tdorssers/weather-station/README.md

# weather-station

## Base

 A BME280 barometric sensor is used to implement a simple Zambretti weather forecasting algorithm by calculating the Pa/h trend. Up to 16 wireless DS18B20, AM2320, AHT20 or SHT30 sensors transmit NRZ encoded packets with CRC data using a 433MHz ASK/OOK module connected to the hardware UART at 1200 baud. Up to 6 remote sensors are shown on the LCD. Minimum and maximum temperatures and humidity values are stored in 4 six hour periods. A software UART implementation using Timer1 is interfacing with the GPS module at 9600 baud. Libc timekeeping uses the GPS position to determine day and night display mode, which can be overridden from the menu. Time zone and daylight saving time can be set from the menu which is shown by touching the main screen. Different temperature and pressure units can be selected. The LCD back light level is auto adjusted using a 5528 LDR and can be set manually. Screen orientation can be adjusted and the touch screen requires calibration which is done by touching the screen edges. The remote sensors can be named with 3 characters from the menu. Calibration and names are stored in EEPROM.

It uses a speed optimized ILI9341 driver for AVR which implements graphics drawing primitives and uses openGLCD library fonts.

### Hardware

* ATmega328P @ 12 MHz
* RFM210LCF 433MHz ASK/OOK receiver module
* BME280 digital humidity, pressure and temperature sensor
* ILI9341 driver for 240x320 TFT LCD module
* XPT2046 touch screen controller
* NEO-6M GPS module
* GL5528 LDR

### Schematic

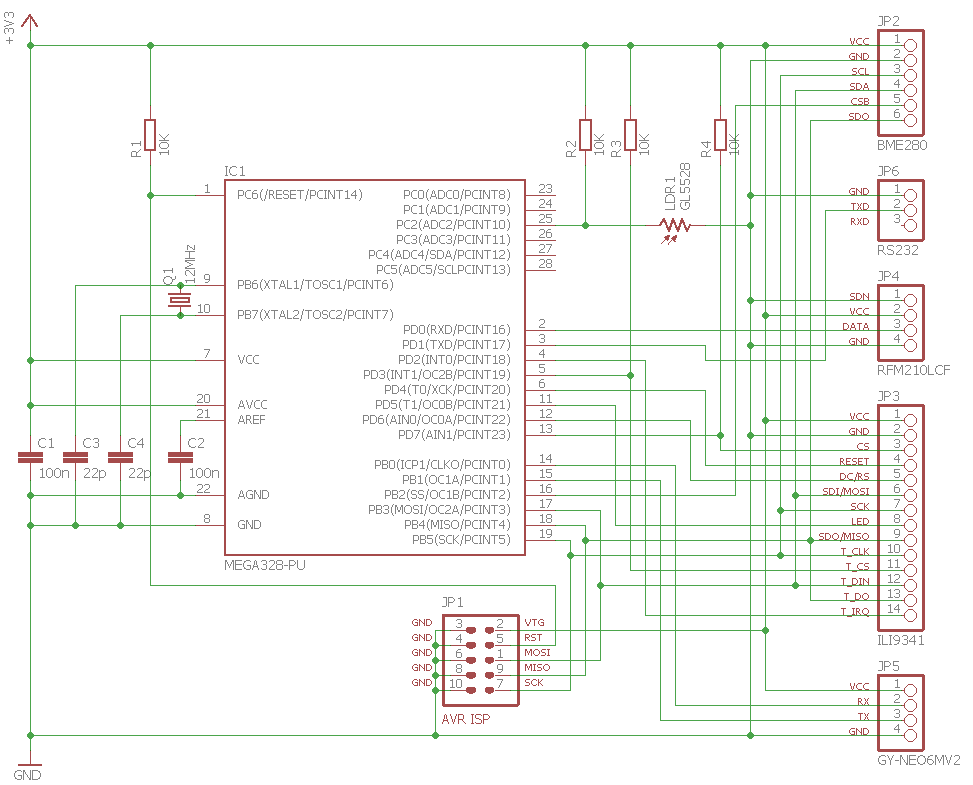
[picture p1: schematic/base.png]


### Prototype

Day time display mode:

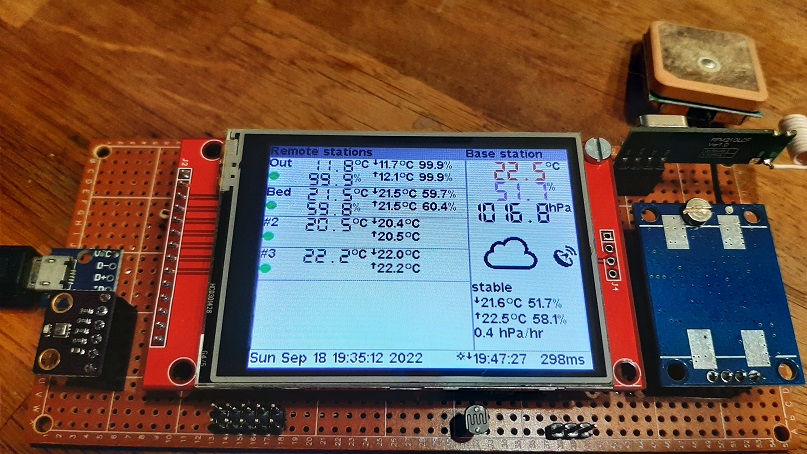
[picture p2: media/base_station_day.jpg]


Night time display mode:

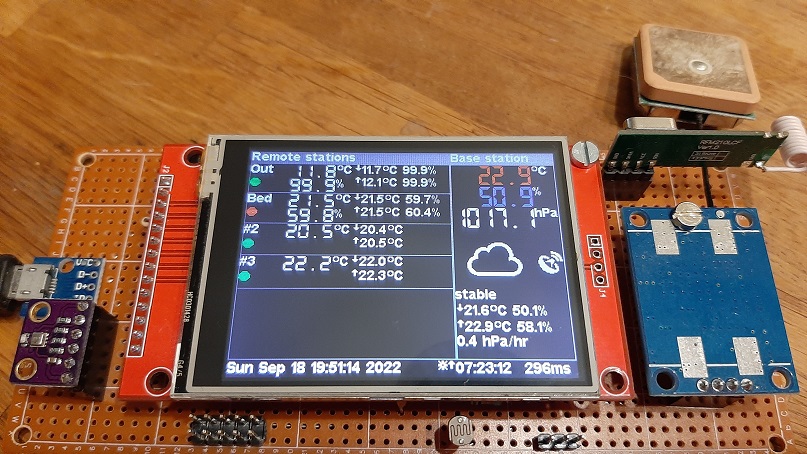
[picture p3: media/base_station_night.jpg]


Main menu with touch buttons:

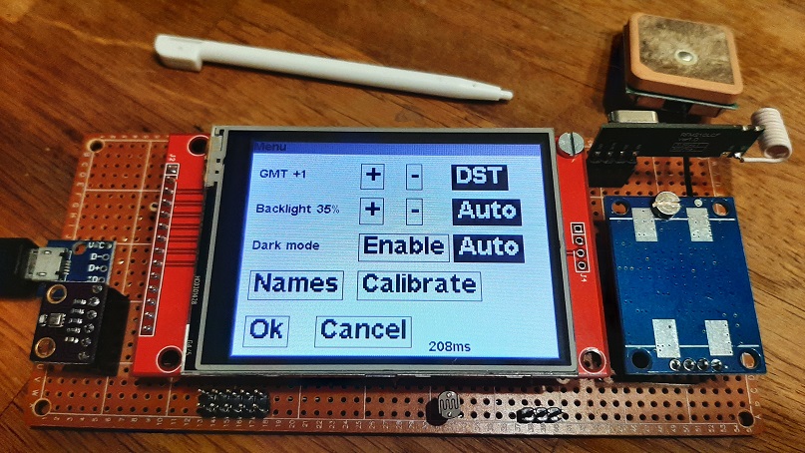
[picture p4: media/base_station_menu.jpg]


Touch screen keyboard to name remote sensors:

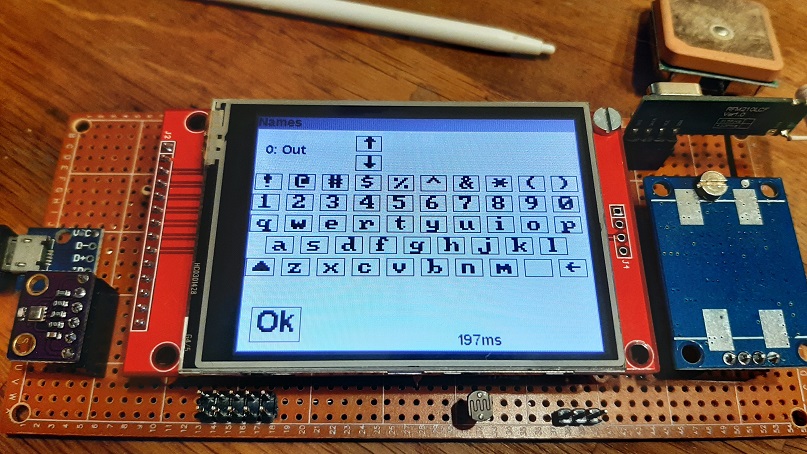
[picture p5: media/base_station_keys.jpg]


## Remote ATtiny25/45/85

Remote temperature sensor module with drivers for DS18B20, AM2320, AHT20 and SHT30 sensor. The DIP switches are used to set the unit address. Every 8 seconds a NRZ encoded packet with CRC data is transmitted using a 433MHz ASK/OOK module connected to the USI UART at 1200 baud. Compiling for an ATtiny25 disables the SHT30 driver and requires `-Os`.

### Hardware

* ATtiny25/45/85 @ 1 MHz
* RFM85 433MHz ASK/OOK transmitter module
* AHT20/AM2320/SHT30 digital temperature and humidity sensor
* DS18B20 digital temperature sensor
* 4 DIP switches

### Schematic

AHT20/AM2320/SHT30 wiring:

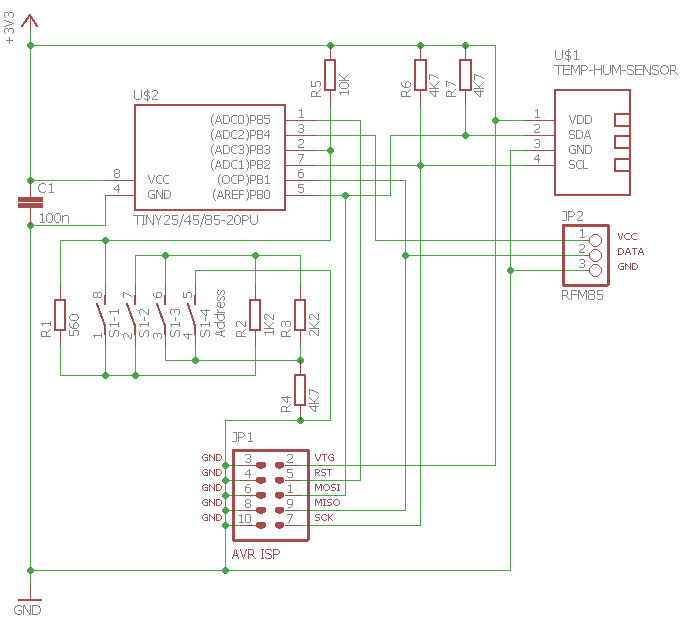
[picture p6: schematic/remote_25_45_85.png]


DS18B20 wiring:

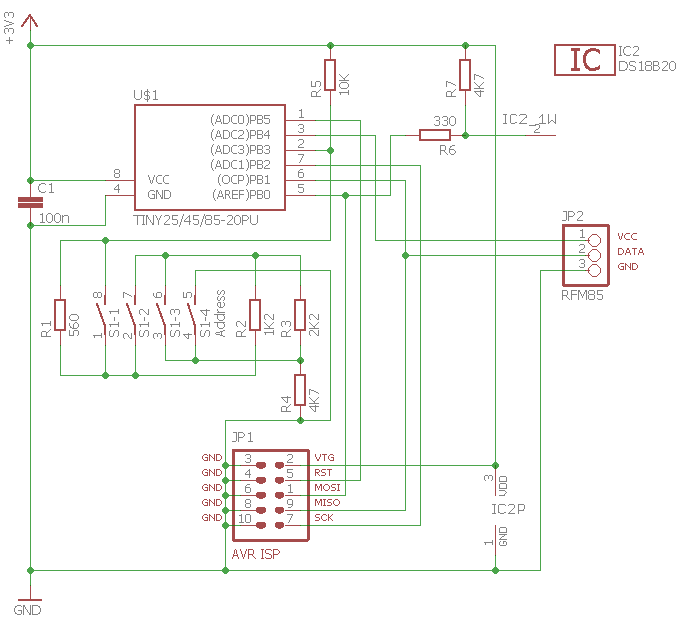
[picture p7: schematic/remote_25_45_85-1wire.png]


### Prototype

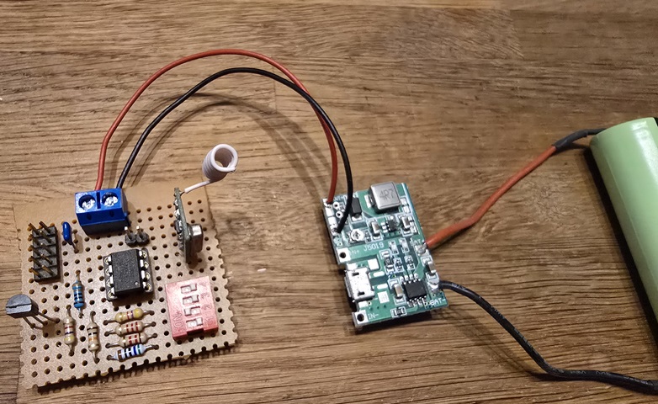
[picture p8: media/remote_25_45_85.jpg]


## Remote ATtiny2313/2313A/4313

Remote temperature sensor module with drivers for DS18B20, AM2320, AHT20 and SHT30 sensor. The DIP switches are used to set the unit address. Every 8 seconds a NRZ encoded packet with CRC data is transmitted using a 433MHz ASK/OOK module connected to the hardware USART at 1200 baud. Compiling for an ATtiny4313 enables the SHT30 driver.

### Hardware

* ATtiny2313/2313A/4313 @ 1 MHz
* RFM85 433MHz ASK/OOK transmitter module
* AHT20/AM2320 digital temperature and humidity sensor
* DS18B20 digital temperature sensor
* 4 DIP switches

### Schematic

AHT20/AM2320 wiring:

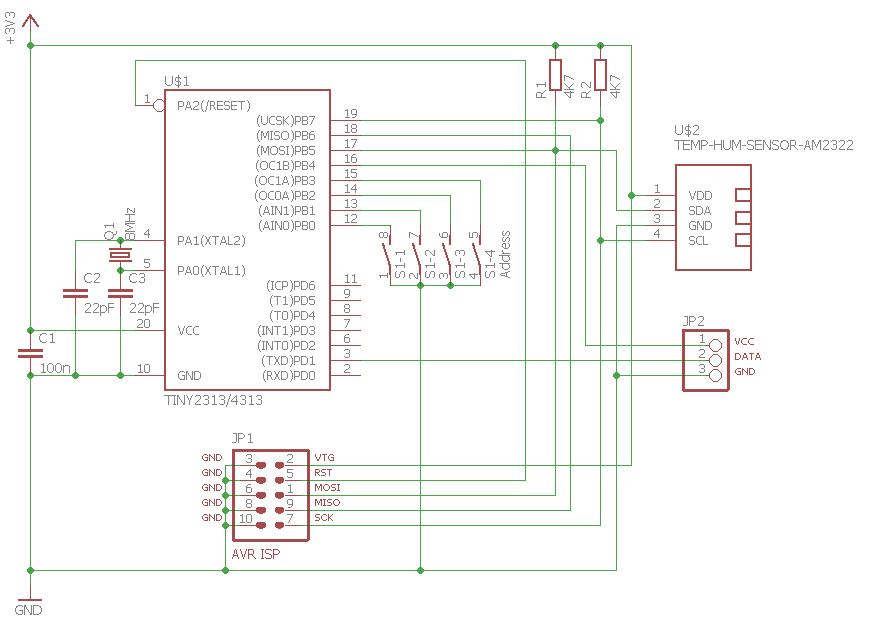
[picture p9: schematic/remote_2313_4313.png]


DS18B20 wiring:

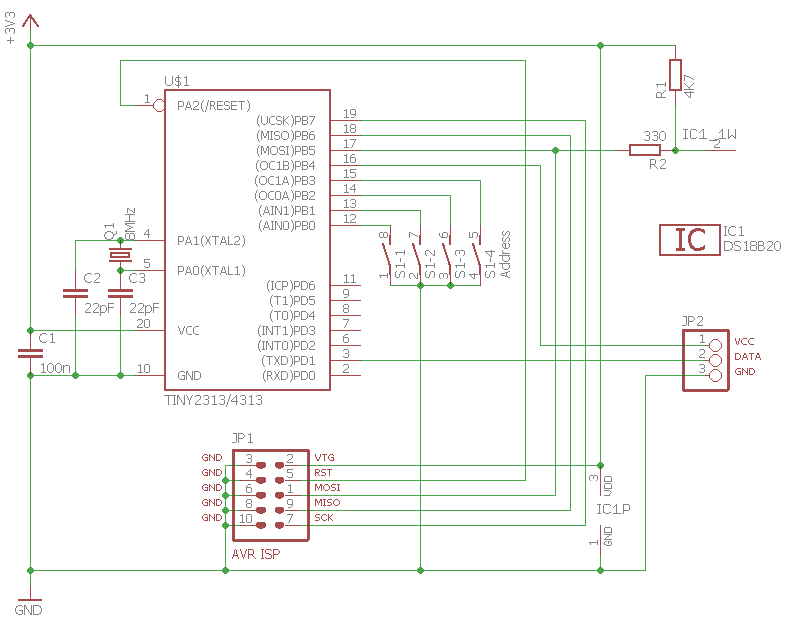
[picture p10: schematic/remote_2313_4313-1wire.png]

 
### Prototype

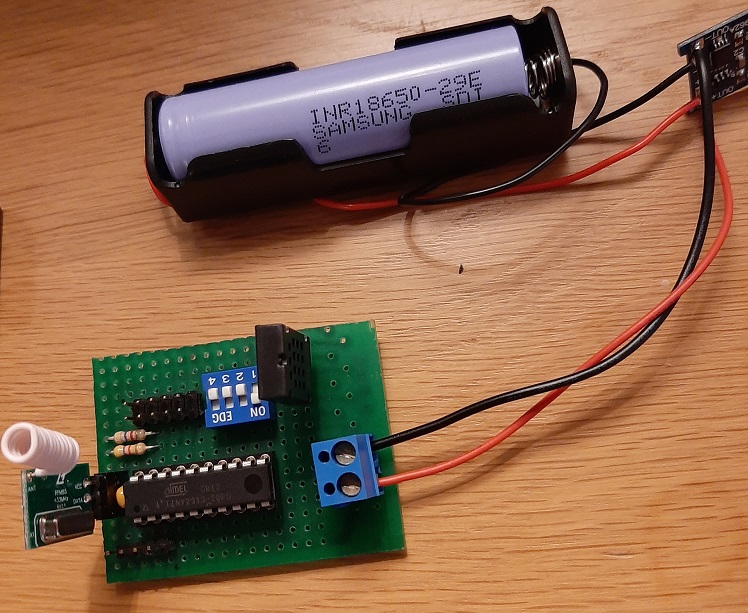
[picture p11: media/remote_2313_4313.jpg]


## Firmware
The firmware has been developed in Atmel Studio 7 using GCC C and can be uploaded to the AVR using the ISP connector and an ISP programmer such as [USBasp tool](http://www.fischl.de/usbasp/) using [avrdude](http://www.nongnu.org/avrdude/).

### Base

`avrdude -p m328p -c usbasp -U flash:w:base.hex:i -U lfuse:w:0x62:m -U hfuse:w:0xdf:m`

### Remote ATtiny2313/2313A/4313

`avrdude -p t2313 -c usbasp -U flash:w:remote_2313_4313.hex:i -U lfuse:w:0x7f:m -U hfuse:w:0xdf:m`

### Remote ATtiny25/45/85

`avrdude -p t85 -c usbasp -U flash:w:remote_25_45_85.hex:i -U lfuse:w:0x62:m -U hfuse:w:0xdf:m`
