tdorssers/weather-station/schematic/base.sch

## EAGLE design schematic/base.sch (2024-12-08)

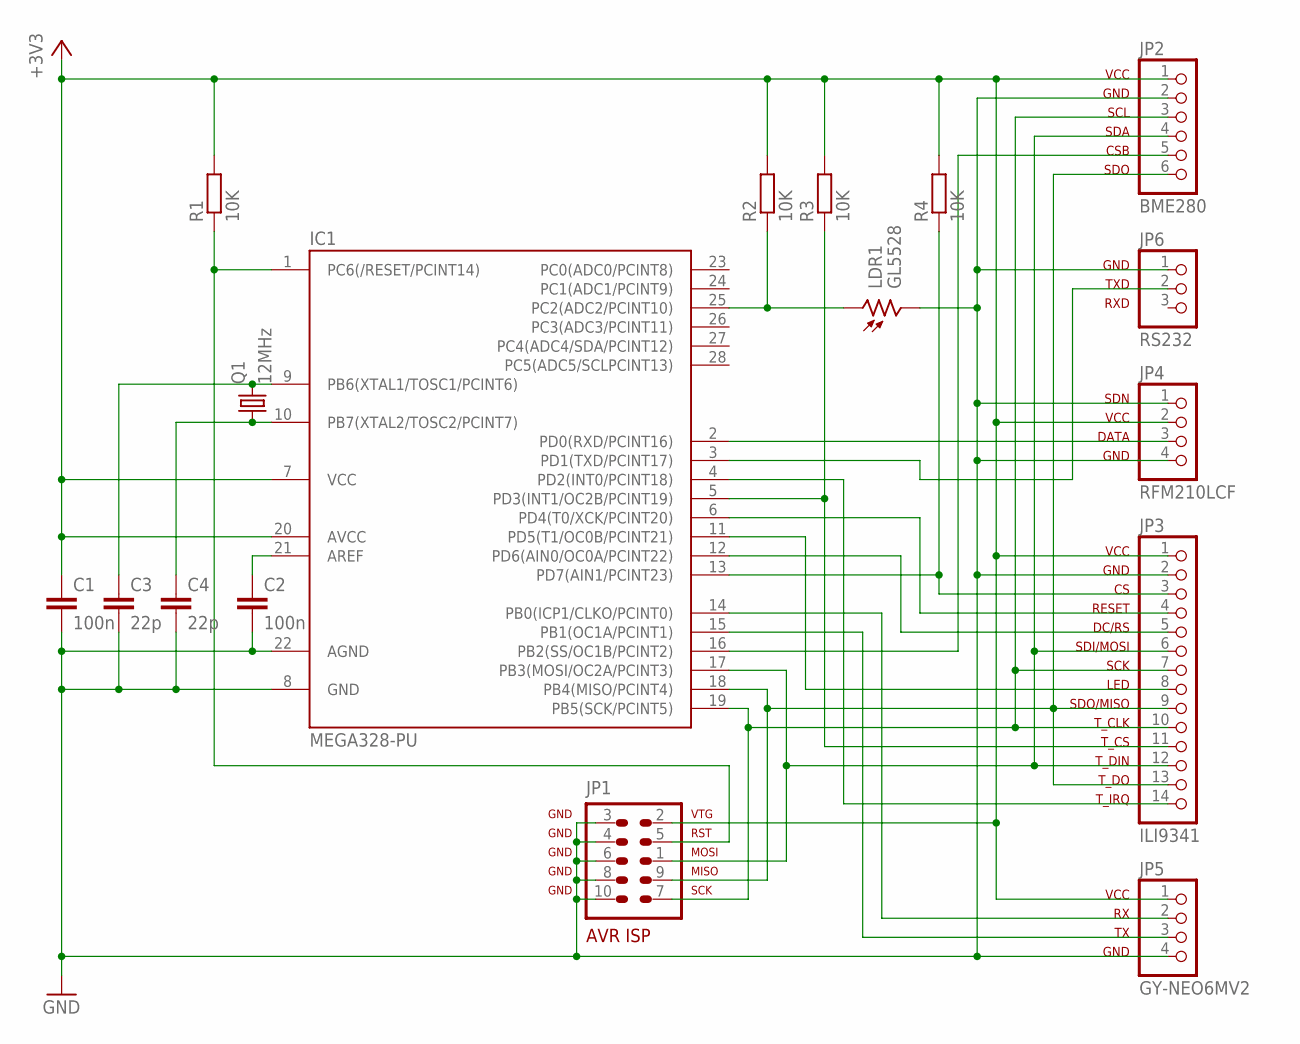
[picture p12: schematic base.sch]

Parts:
C1, C2: 100n; C025-025X050
C3, C4: 22p; C025-025X050
IC1: MEGA328-PU; DIL28-3
JP1: AVR-ISP-10
JP2: BME280; 1X06
JP3: ILI9341; 1X14
JP4: RFM210LCF; 1X04
JP5: GY-NEO6MV2; 1X04
JP6: RS232; 1X03
LDR1: GL5528; TO46-VT200
Q1: 12MHz; HC49U-V
R1, R2, R3, R4: 10K; 0204/7

Connections:
+3V3: C1.1, IC1.7 (VCC), IC1.20 (AVCC), JP1.2, JP2.1, JP3.1, JP4.2, JP5.1, R1.2, R2.2, R3.2, R4.2
GND: C1.2, C2.2, C3.2, C4.2, IC1.8 (GND), IC1.22 (AGND), JP1.3, JP1.4, JP1.6, JP1.8, JP1.10, JP2.2, JP3.2, JP4.1, JP4.4, JP5.4, JP6.1, LDR1.2
unnamed: IC1.16 (PB2(SS/OC1B/PCINT2)), JP2.5
unnamed: IC1.1 (PC6(/RESET/PCINT14)), JP1.5, R1.1
unnamed: IC1.18 (PB4(MISO/PCINT4)), JP1.9, JP2.6, JP3.9, JP3.13
unnamed: C2.1, IC1.21 (AREF)
unnamed: IC1.2 (PD0(RXD/PCINT16)), JP4.3
unnamed: IC1.12 (PD6(AIN0/OC0A/PCINT22)), JP3.5
unnamed: IC1.13 (PD7(AIN1/PCINT23)), JP3.3, R4.1
unnamed: IC1.17 (PB3(MOSI/OC2A/PCINT3)), JP1.1, JP2.4, JP3.6, JP3.12
unnamed: IC1.4 (PD2(INT0/PCINT18)), JP3.14
unnamed: IC1.6 (PD4(T0/XCK/PCINT20)), JP3.4
unnamed: IC1.11 (PD5(T1/OC0B/PCINT21)), JP3.8
unnamed: IC1.19 (PB5(SCK/PCINT5)), JP1.7, JP2.3, JP3.7, JP3.10
unnamed: IC1.25 (PC2(ADC2/PCINT10)), LDR1.1, R2.1
unnamed: IC1.14 (PB0(ICP1/CLKO/PCINT0)), JP5.2
unnamed: IC1.15 (PB1(OC1A/PCINT1)), JP5.3
unnamed: IC1.5 (PD3(INT1/OC2B/PCINT19)), JP3.11, R3.1
unnamed: IC1.3 (PD1(TXD/PCINT17)), JP6.2
unnamed: C4.1, IC1.10 (PB7(XTAL2/TOSC2/PCINT7)), Q1.1
unnamed: C3.1, IC1.9 (PB6(XTAL1/TOSC1/PCINT6)), Q1.2

Notes on the sheet:
VCC GND SCL SDA CSB SDO
VCC GND CS RESET DC/RS SDI/MOSI SCK LED SDO/MISO T_CLK T_CS T_DIN T_DO T_IRQ
SDN VCC DATA GND
VCC RX TX GND
GND TXD RXD
