tdorssers/weather-station/schematic/remote_25_45_85-1wire.sch

## EAGLE design schematic/remote_25_45_85-1wire.sch (2024-12-22)

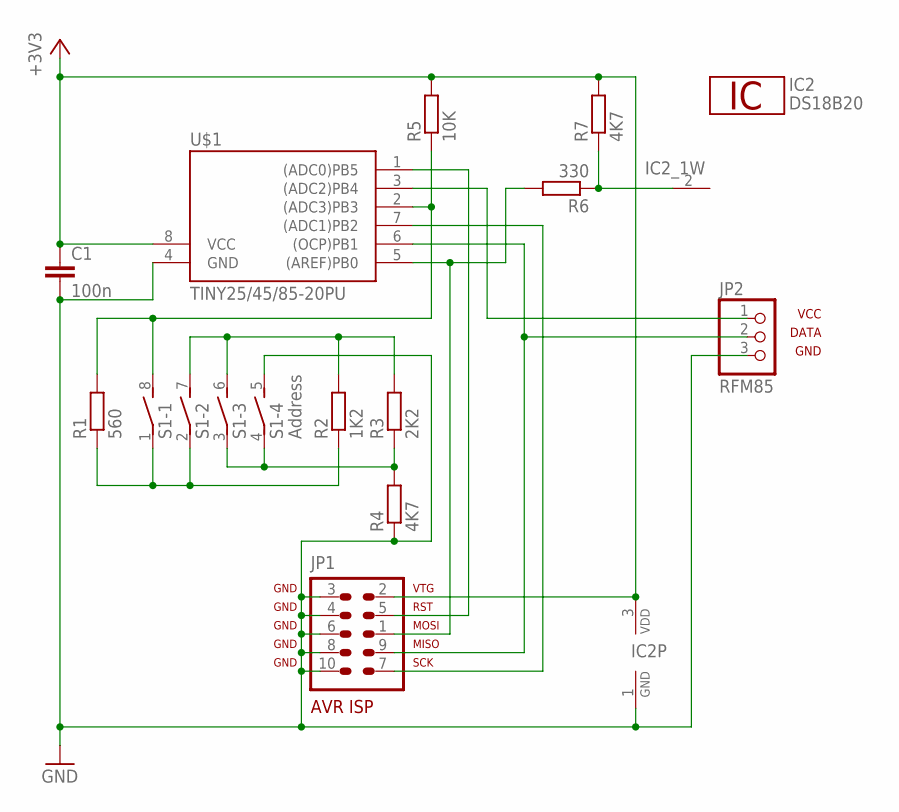
[picture p13: schematic remote_25_45_85-1wire.sch]

Parts:
C1: 100n; C025-025X050
IC2: DS18B20; TO92-
JP1: AVR-ISP-10
JP2: RFM85; 1X03
R1: 560; 0204/7
R2: 1K2; 0204/7
R3: 2K2; 0204/7
R4, R7: 4K7; 0204/7
R5: 10K; 0204/7
R6: 330; 0204/7
S1: Address; DIP04S
U$1: TINY25/45/85-20PU; SOIC8

Connections:
+3V3: C1.1, IC2.3 (VDD), JP1.2, R5.2, R7.2, U$1.8 (VCC)
GND: C1.2, IC2.1 (GND), JP1.3, JP1.4, JP1.6, JP1.8, JP1.10, JP2.3, R4.1, S1.5 (2), U$1.4 (GND)
unnamed: JP1.1, U$1.5 ((AREF)PB0)
unnamed: JP1.7, U$1.7 ((ADC1)PB2)
unnamed: JP1.9, JP2.2, U$1.6 ((OCP)PB1)
unnamed: R1.1, R2.1, S1.1, S1.2 (1)
unnamed: JP2.1, U$1.3 ((ADC2)PB4)
unnamed: JP1.5, U$1.1 ((ADC0)PB5)
unnamed: R1.2, R5.1, S1.8 (2), U$1.2 ((ADC3)PB3)
unnamed: R2.2, R3.2, S1.6 (2), S1.7 (2)
unnamed: R3.1, R4.2, S1.3 (1), S1.4 (1)
unnamed: IC2.2 (1W), R6.1, R7.1

Notes on the sheet:
VCC DATA GND
