tdorssers/weather-station/schematic/remote_2313_4313-1wire.sch

## EAGLE design schematic/remote_2313_4313-1wire.sch (2021-01-24)

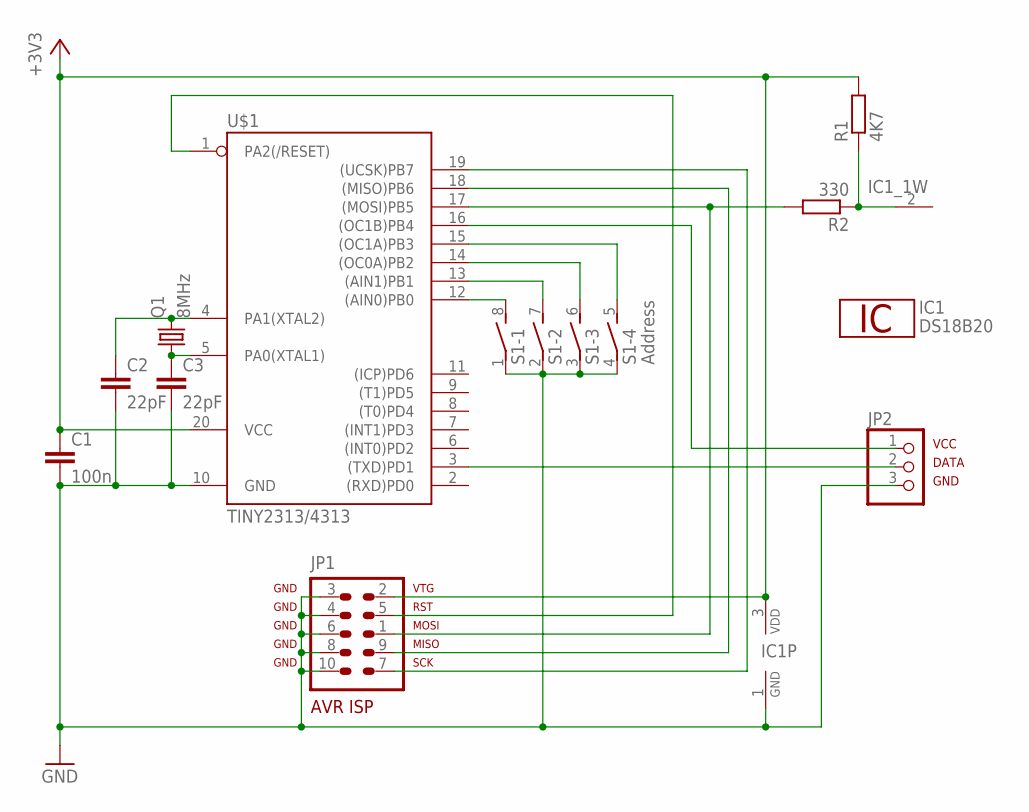
[picture p15: schematic remote_2313_4313-1wire.sch]

Parts:
C1: 100n; C025-025X050
C2, C3: 22pF; C025-024X044
IC1: DS18B20; TO92-
JP1: AVR-ISP-10
JP2: PINHD-1X3; 1X03
Q1: 8MHz; HC49U-V
R1: 4K7; 0204/5
R2: 330; 0204/5
S1: Address; DIP04S
U$1: TINY2313/4313; DIL20

Connections:
+3V3: C1.1, IC1.3 (VDD), JP1.2, R1.2, U$1.20 (VCC)
GND: C1.2, C2.2, C3.2, IC1.1 (GND), JP1.3, JP1.4, JP1.6, JP1.8, JP1.10, JP2.3, S1.1, S1.2 (1), S1.3 (1), S1.4 (1), U$1.10 (GND)
unnamed: S1.8 (2), U$1.12 ((AIN0)PB0)
unnamed: S1.7 (2), U$1.13 ((AIN1)PB1)
unnamed: S1.6 (2), U$1.14 ((OC0A)PB2)
unnamed: S1.5 (2), U$1.15 ((OC1A)PB3)
unnamed: JP2.1, U$1.16 ((OC1B)PB4)
unnamed: JP1.1, R2.2, U$1.17 ((MOSI)PB5)
unnamed: JP2.2, U$1.3 ((TXD)PD1)
unnamed: JP1.7, U$1.19 ((UCSK)PB7)
unnamed: JP1.9, U$1.18 ((MISO)PB6)
unnamed: JP1.5, U$1.1 (PA2(/RESET))
unnamed: C3.1, Q1.1, U$1.5 (PA0(XTAL1))
unnamed: IC1.2 (1W), R1.1, R2.1
unnamed: C2.1, Q1.2, U$1.4 (PA1(XTAL2))

Notes on the sheet:
VCC DATA GND
