tdorssers/weather-station/base_station/weatherIcons.h

/*
 * weatherIcons.h
 *
 * Created: 15-1-2021 20:59:00
 *  Author: Tim Dorssers
 */ 


#ifndef WEATHERICONS_H_
#define WEATHERICONS_H_

const char clear_icon[] PROGMEM = {
	0xbf, 0xbf, 0xbf, 0xbf, 0xbf, 0xbf, 0x9e, 0x03, 0xb7, 0x07, 0xb8, 0x0f,
	0xb8, 0x0f, 0xb8, 0x0f, 0xac, 0x01, 0x60, 0x03, 0x40, 0xa2, 0x0f, 0x40,
	0x07, 0x60, 0x03, 0x9c, 0x1f, 0x40, 0x07, 0x70, 0x03, 0x9d, 0x1f, 0x40,
	0x01, 0x7c, 0xa4, 0x1f, 0x8d, 0x1f, 0xa4, 0x0f, 0x8c, 0x0f, 0xa5, 0x07,
	0x7e, 0x60, 0x01, 0xa4, 0x61, 0xc7, 0x10, 0xac, 0xcd, 0xb0, 0x7f, 0x7c,
	0x01, 0xaa, 0x0f, 0x70, 0x03, 0xa9, 0x0f, 0x40, 0x0f, 0xaa, 0x0f, 0x00,
	0x0f, 0xa0, 0x3f, 0x38, 0x8a, 0x07, 0x3f, 0x97, 0xc7, 0x3c, 0x8a, 0x4f,
	0x7f, 0x97, 0xc7, 0x3c, 0x8a, 0x4f, 0x7f, 0x98, 0x7f, 0x38, 0x8a, 0x47,
	0x3f, 0xa2, 0x07, 0x87, 0x07, 0xa9, 0x0f, 0x00, 0x0f, 0xaa, 0x0f, 0x00,
	0x0f, 0xab, 0x0f, 0x60, 0x03, 0xaa, 0x7f, 0x7c, 0x01, 0xab, 0xcd, 0xad,
	0x47, 0xc8, 0x38, 0xa7, 0x0f, 0x7c, 0x41, 0x07, 0xa2, 0x1f, 0x8d, 0x1f,
	0xa2, 0x1f, 0x8f, 0x1f, 0xa0, 0x1f, 0x00, 0x03, 0x70, 0x03, 0x9c, 0x0f,
	0x40, 0x07, 0x60, 0x03, 0x9d, 0x03, 0x60, 0x03, 0x60, 0xaf, 0x0f, 0xb8,
	0x0f, 0xb8, 0x0f, 0xb8, 0x0f, 0xb8, 0x0f, 0xb9, 0x03, 0xbf, 0xbf, 0xbf,
	0xbf, 0xbf, 0xbf, 0xbf, 0x99
};

const char nt_clear_icon[] PROGMEM = {
	0xbf, 0xbf, 0xbf, 0xbf, 0xbf, 0xbf, 0xbf, 0xbf, 0xbf, 0xbf, 0xbf, 0xbf,
	0xbf, 0x9d, 0xc7, 0xb4, 0xc9, 0xb4, 0xc9, 0xb3, 0xca, 0xb4, 0x1f, 0x0f,
	0xb0, 0x1f, 0x0e, 0xb0, 0x0f, 0x1e, 0xb1, 0x0f, 0x1e, 0xb0, 0x0f, 0x1c,
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
	0x0f, 0x0f, 0x3e, 0xaa, 0x07, 0x0f, 0x38, 0xaa, 0x47, 0x07, 0x18, 0xaa,
	0x43, 0x07, 0x18, 0xb0, 0x07, 0x30, 0xb0, 0x0f, 0x20, 0xb1, 0x0f, 0x20,
	0xb0, 0x0f, 0xb8, 0x0f, 0xb9, 0x03, 0xbf, 0xbf, 0xbf, 0xbf, 0x9f
};


#endif /* WEATHERICONS_H_ */
