tdorssers/weather-station/base_station/fonts/lcdnums12x16.h

/*
 * Fixed width font for numbers that looks like LCD panel digits
 * This font including pad pixels, will render 12x16 pixels on the display 
 *
 * This font is very useful when using overstrike as all characters & numbers
 * are all the same width.
 *
 * This font is not a complete character set. The font only contains
 * the characters: '+', ',', '-', '.', '/', '0', '1', '2', '3', '4', '5', '6', '7', '9', ':'
 *
 * This font is nice for certain applications like clocks, signed values or decimal point values.
 *
 */

GLCDFONTDECL(lcdnums12x16) =
{
  0x0, 0x0,	// size of zero indicates fixed width font
    11,		// width  (will be 12 with pad pixel on right)
    16,		// height (will be 17 with pad pixel on bottom)
    '+',	// first char
    16,		// char count
0x00, 0x00, 0x00, 0x80, 0x80, 0xe0, 0xe0, 0x80, 0x80, 0x00, 0x00,  
0x00, 0x00, 0x01, 0x03, 0x03, 0x0f, 0x0f, 0x03, 0x03, 0x01, 0x00,    // +

0x00, 0x00, 0x00, 0x00, 0x00, 0x00, 0x00, 0x00, 0x00, 0x00, 0x00,
0x00, 0x00, 0x00, 0x00, 0x80, 0xe0, 0x60, 0x00, 0x00, 0x00, 0x00,    // ,

0x00, 0x00, 0x00, 0x80, 0x80, 0x80, 0x80, 0x80, 0x80, 0x00, 0x00,
0x00, 0x00, 0x01, 0x03, 0x03, 0x03, 0x03, 0x03, 0x03, 0x01, 0x00,    // -

0x00, 0x00, 0x00, 0x00, 0x00, 0x00, 0x00, 0x00, 0x00, 0x00, 0x00,
0x00, 0x00, 0x00, 0x00, 0x00, 0xc0, 0xc0, 0x00, 0x00, 0x00, 0x00,    // .

0x00, 0x00, 0x02, 0x86, 0x86, 0x86, 0x86, 0x86, 0x86, 0x02, 0x00,
0x00, 0x00, 0x81, 0xc3, 0xc3, 0xc3, 0xc3, 0xc3, 0xc3, 0x81, 0x00,    // /

0x00, 0xfc, 0x7a, 0x06, 0x06, 0x06, 0x06, 0x06, 0x06, 0x7a, 0xfc,
0x00, 0x7e, 0xbc, 0xc0, 0xc0, 0xc0, 0xc0, 0xc0, 0xc0, 0xbc, 0x7e,    // 0

0x00, 0x00, 0x00, 0x00, 0x00, 0x00, 0x00, 0x00, 0x00, 0x78, 0xfc,
0x00, 0x00, 0x00, 0x00, 0x00, 0x00, 0x00, 0x00, 0x00, 0x3c, 0x7e,    // 1

0x00, 0x00, 0x02, 0x86, 0x86, 0x86, 0x86, 0x86, 0x86, 0x7a, 0xfc,
0x00, 0x7e, 0xbd, 0xc3, 0xc3, 0xc3, 0xc3, 0xc3, 0xc3, 0x81, 0x00,    // 2

0x00, 0x00, 0x02, 0x86, 0x86, 0x86, 0x86, 0x86, 0x86, 0x7a, 0xfc,
0x00, 0x00, 0x81, 0xc3, 0xc3, 0xc3, 0xc3, 0xc3, 0xc3, 0xbd, 0x7e,    // 3

0x00, 0xfc, 0x78, 0x80, 0x80, 0x80, 0x80, 0x80, 0x80, 0x78, 0xfc,
0x00, 0x00, 0x01, 0x03, 0x03, 0x03, 0x03, 0x03, 0x03, 0x3d, 0x7e,    // 4

0x00, 0xfc, 0x7a, 0x86, 0x86, 0x86, 0x86, 0x86, 0x86, 0x02, 0x00,
0x00, 0x00, 0x81, 0xc3, 0xc3, 0xc3, 0xc3, 0xc3, 0xc3, 0xbd, 0x7e,    // 5

0x00, 0xfc, 0x7a, 0x86, 0x86, 0x86, 0x86, 0x86, 0x86, 0x02, 0x00,
0x00, 0x7e, 0xbd, 0xc3, 0xc3, 0xc3, 0xc3, 0xc3, 0xc3, 0xbd, 0x7e,    // 6

0x00, 0x00, 0x02, 0x06, 0x06, 0x06, 0x06, 0x06, 0x06, 0x7a, 0xfc,
0x00, 0x00, 0x00, 0x00, 0x00, 0x00, 0x00, 0x00, 0x00, 0x3c, 0x7e,    // 7

0x00, 0xfc, 0x7a, 0x86, 0x86, 0x86, 0x86, 0x86, 0x86, 0x7a, 0xfc,
0x00, 0x7e, 0xbd, 0xc3, 0xc3, 0xc3, 0xc3, 0xc3, 0xc3, 0xbd, 0x7e,    // 8

0x00, 0xfc, 0x7a, 0x86, 0x86, 0x86, 0x86, 0x86, 0x86, 0x7a, 0xfc,
0x00, 0x00, 0x81, 0xc3, 0xc3, 0xc3, 0xc3, 0xc3, 0xc3, 0xbd, 0x7e,    // 9

0x00, 0x00, 0x00, 0x00, 0x00, 0x18, 0x18, 0x00, 0x00, 0x00, 0x00,
0x00, 0x00, 0x00, 0x00, 0x00, 0x18, 0x18, 0x00, 0x00, 0x00, 0x00     // :
};
