tdorssers/weather-station/base_station/fonts/lcdnums14x24.h

/*
 * Fixed width font for numbers that looks like LCD panel digits
 * This font including pad pixels, will render 14x24 pixels on the display 
 *
 * This font is very useful when using overstrike as all characters & numbers
 * are all the same width.
 *
 * This font is not a complete character set. The font only contains
 * the characters: '+', ',', '-', '.', '/', '0', '1', '2', '3', '4', '5', '6', '7', '9', ':'
 *
 * This font is nice for certain applications like clocks, signed values or decimal point values.
 *
 */


GLCDFONTDECL(lcdnums14x24) =
{
  0x0, 0x0,	// size of zero indicates fixed width font
    13,		// width  (will be 14 with pad pixel on right)
    24,		// height (will be 25 with pad pixel on bottom)
    '+',	// first char
    16,		// char count

0x00, 0x00, 0x00, 0x00, 0x00, 0x00, 0x00, 0x00, 0x00, 0x00, 0x00, 0x00, 0x00,
0x00, 0x00, 0x10, 0x38, 0x38, 0x38, 0xff, 0xff, 0x38, 0x38, 0x38, 0x10, 0x00,
0x00, 0x00, 0x00, 0x00, 0x00, 0x00, 0x03, 0x03, 0x00, 0x00, 0x00, 0x00, 0x00,   // +

0x00, 0x00, 0x00, 0x00, 0x00, 0x00, 0x00, 0x00, 0x00, 0x00, 0x00, 0x00, 0x00,
0x00, 0x00, 0x00, 0x00, 0x00, 0x00, 0x00, 0x00, 0x00, 0x00, 0x00, 0x00, 0x00,
0x00, 0x00, 0x00, 0x00, 0x00, 0x90, 0x78, 0x38, 0x10, 0x00, 0x00, 0x00, 0x00,   // ,

0x00, 0x00, 0x00, 0x00, 0x00, 0x00, 0x00, 0x00, 0x00, 0x00, 0x00, 0x00, 0x00,
0x00, 0x00, 0x10, 0x38, 0x38, 0x38, 0x38, 0x38, 0x38, 0x38, 0x38, 0x10, 0x00,
0x00, 0x00, 0x00, 0x00, 0x00, 0x00, 0x00, 0x00, 0x00, 0x00, 0x00, 0x00, 0x00,   // -

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

0x00, 0x00, 0x00, 0x00, 0x00, 0x80, 0xc0, 0xc0, 0x80, 0x00, 0x00, 0x00, 0x00,
0x00, 0x00, 0x00, 0x00, 0x00, 0x00, 0x01, 0x01, 0x00, 0x00, 0x00, 0x00, 0x00,  // :
0x00, 0x00, 0x00, 0x00, 0x00, 0x04, 0x0e, 0x0e, 0x04, 0x00, 0x00, 0x00, 0x00
};
