tdorssers/weather-station/remote_2313_4313/sht30.h

/*
 * SHT31 Digital Humidity & Temp Sensor
 *
 * Created: 21/12/2024 20:01:27
 *  Author: Tim Dorssers
 */ 


#ifndef SHT30_H_
#define SHT30_H_

#define SHT31_DEFAULT_ADDR 0x44   /* SHT31 Default Address */
#define SHT31_MEAS_HIGHREP_STRETCH 0x2C06 /* Measurement High Repeatability with Clock Stretch Enabled */
#define SHT31_MEAS_MEDREP_STRETCH 0x2C0D /* Measurement Medium Repeatability with Clock Stretch Enabled */
#define SHT31_MEAS_LOWREP_STRETCH 0x2C10 /* Measurement Low Repeatability with Clock Stretch Enabled*/
#define SHT31_MEAS_HIGHREP 0x2400 /* Measurement High Repeatability with Clock Stretch Disabled */
#define SHT31_MEAS_MEDREP 0x240B  /* Measurement Medium Repeatability with Clock Stretch Disabled */
#define SHT31_MEAS_LOWREP 0x2416  /* Measurement Low Repeatability with Clock Stretch Disabled */
#define SHT31_READSTATUS 0xF32D   /* Read Out of Status Register */
#define SHT31_CLEARSTATUS 0x3041  /* Clear Status */
#define SHT31_SOFTRESET 0x30A2    /* Soft Reset */
#define SHT31_HEATEREN 0x306D     /* Heater Enable */
#define SHT31_HEATERDIS 0x3066    /* Heater Disable */
#define SHT31_REG_HEATER_BIT 0x0d /* Status Register Heater Bit */

uint8_t sht30_readTempHum(int16_t *temp, uint16_t *humidity);

#endif /* SHT30_H_ */
